josephrubin/Elijah/image/band.jpg

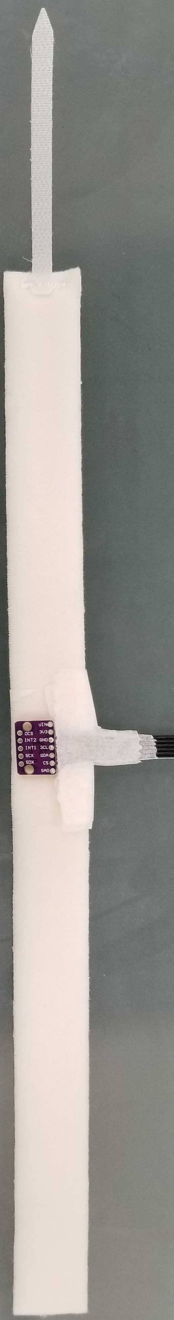
image/band.jpg
