josephrubin/Elijah/image/lit_b.jpg

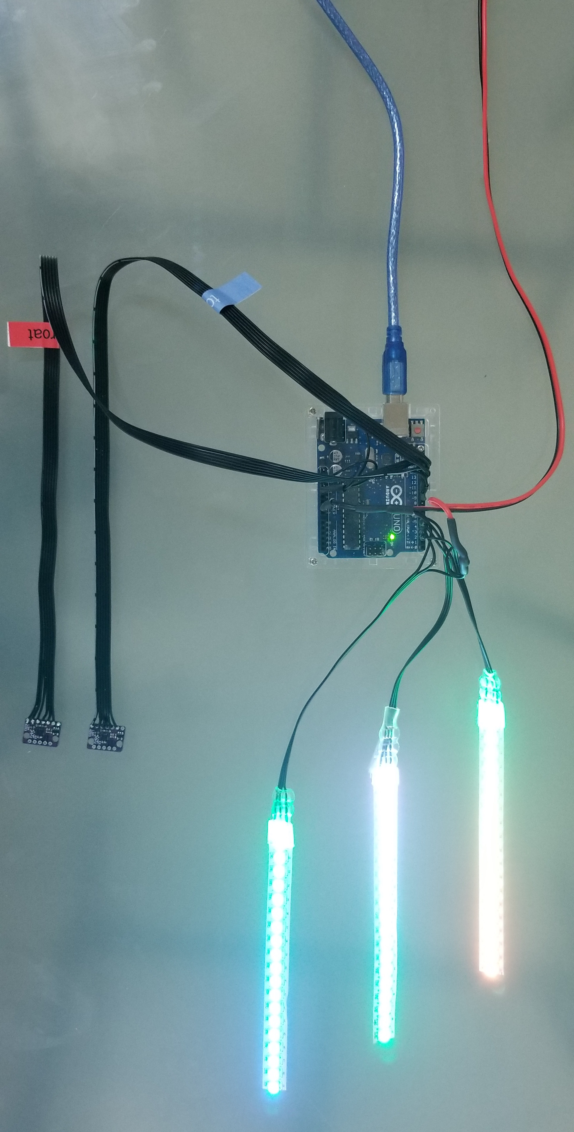
image/lit_b.jpg
