josephrubin/Elijah/README.md

# Elijah
The purpose of Elijah is to provide doctors with an accurate and unobtrusive external swallowing monitor for babies and young children.
Elijah is more convenient than floroscopy, more comfortable than endoscopy, and more precise than using a stethescope.

### Contributing
Read spec/xtra/specification.pdf, especially the hardware section, to build your own setup of Elijah and begin contributing to its codebase.
