josephrubin/Elijah/image/angle.jpg

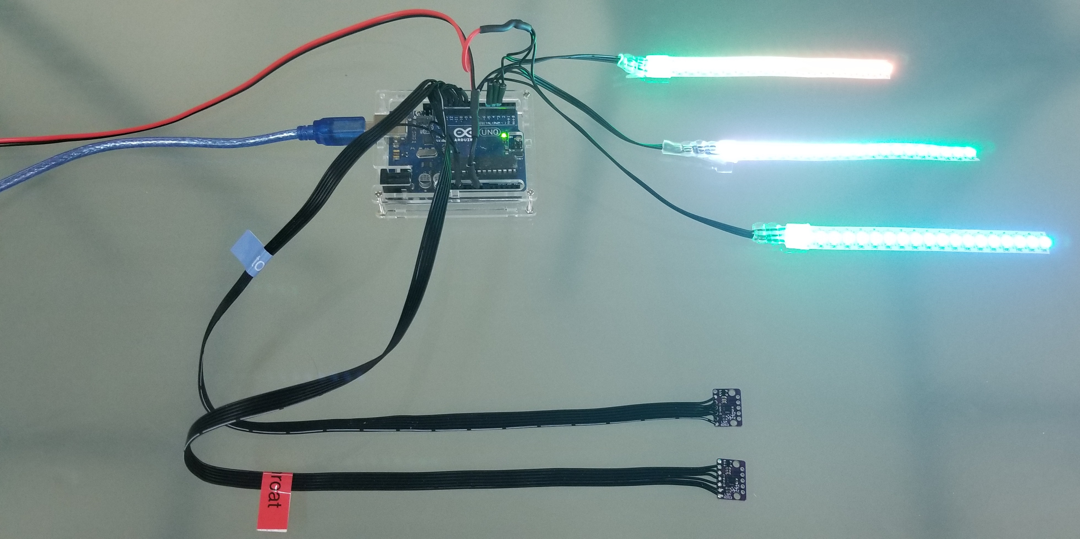
image/angle.jpg
