josephrubin/Elijah/image/close.jpg

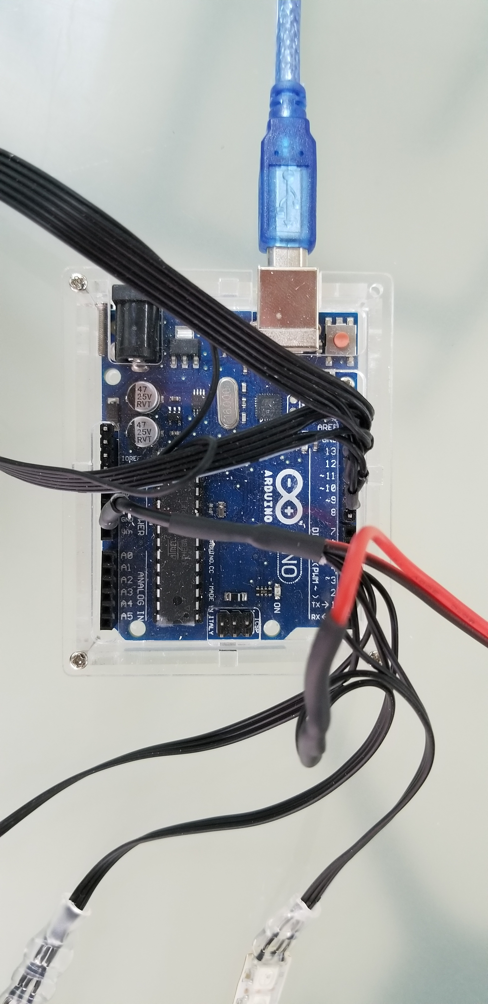
image/close.jpg
