josephrubin/Elijah/image/gui_empty.png

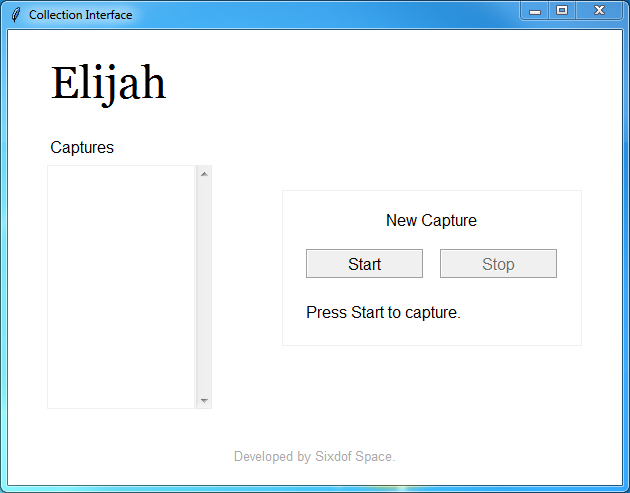
image/gui_empty.png
