josephrubin/Elijah/image/gui_full.png

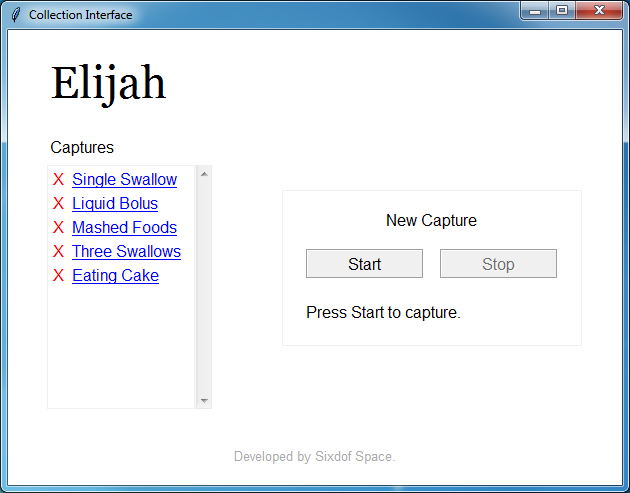
image/gui_full.png
