josephrubin/Elijah/image/limit_switch.jpg

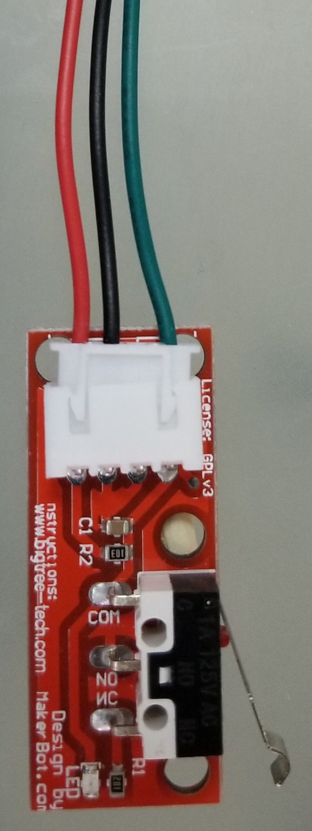
image/limit_switch.jpg
