josephrubin/Elijah/image/lit_a.jpg

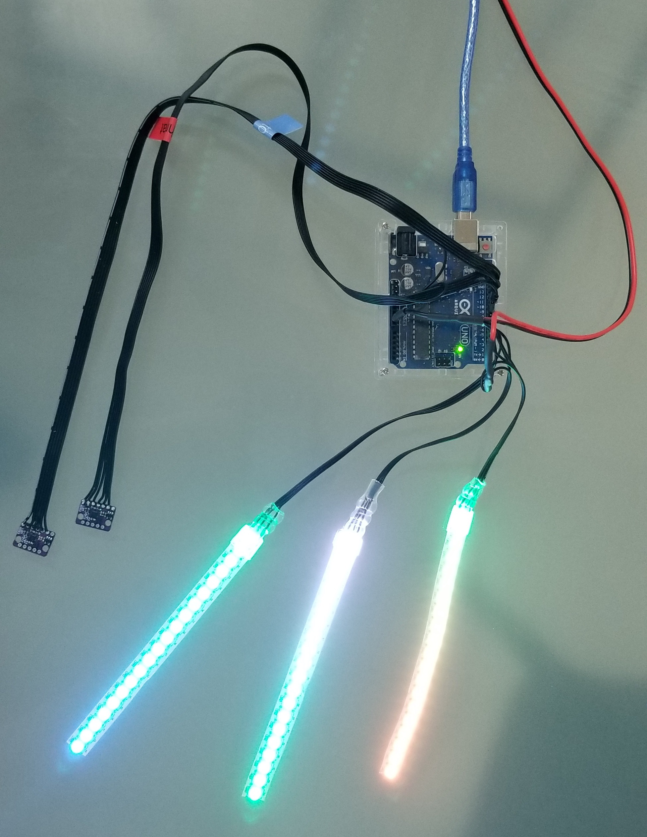
image/lit_a.jpg
