josephrubin/Elijah/image/mems.jpg

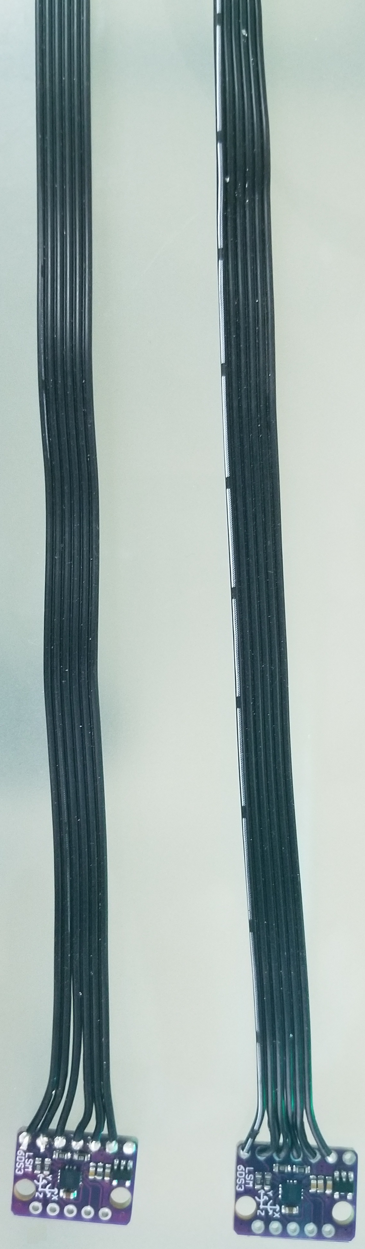
image/mems.jpg
