josephrubin/Elijah/image/patient_x.png

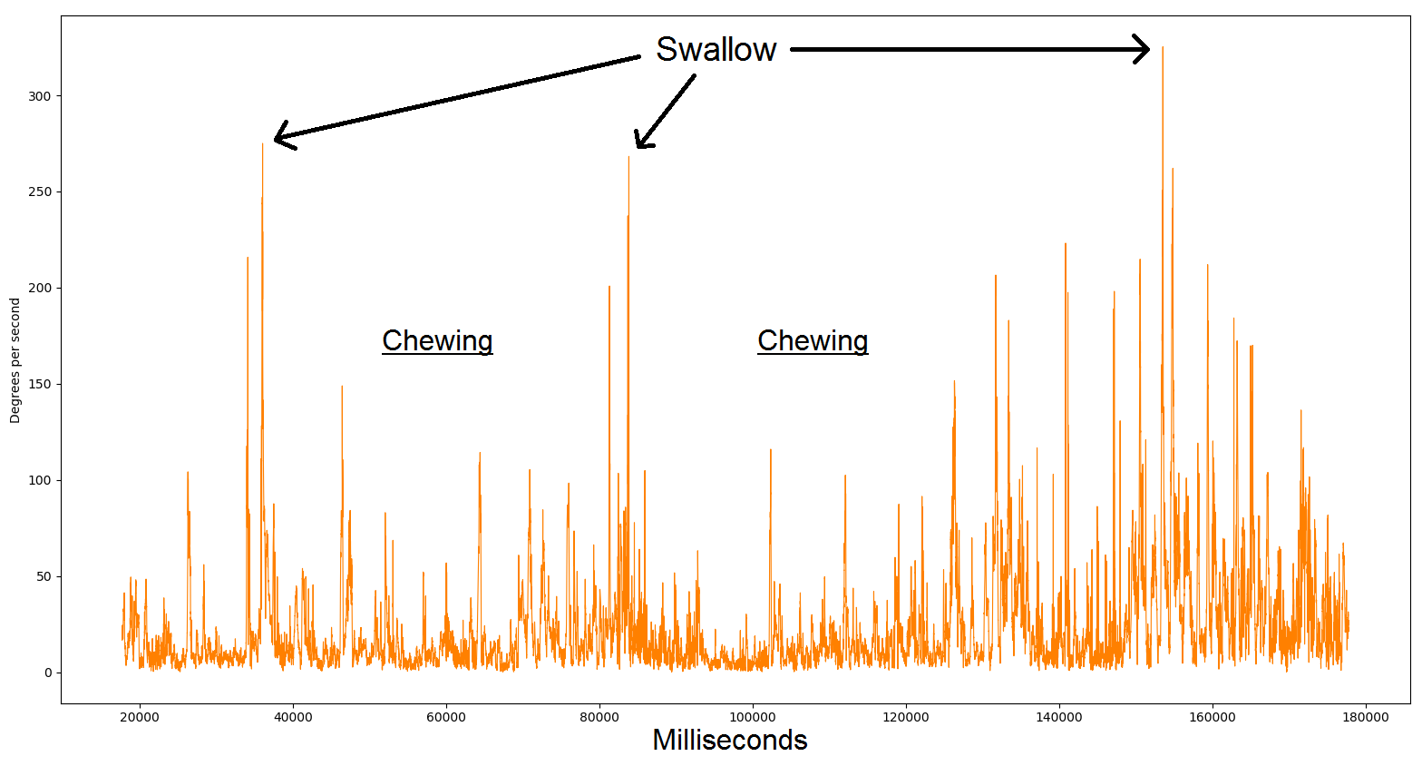
image/patient_x.png
