josephrubin/Elijah/image/plot.png

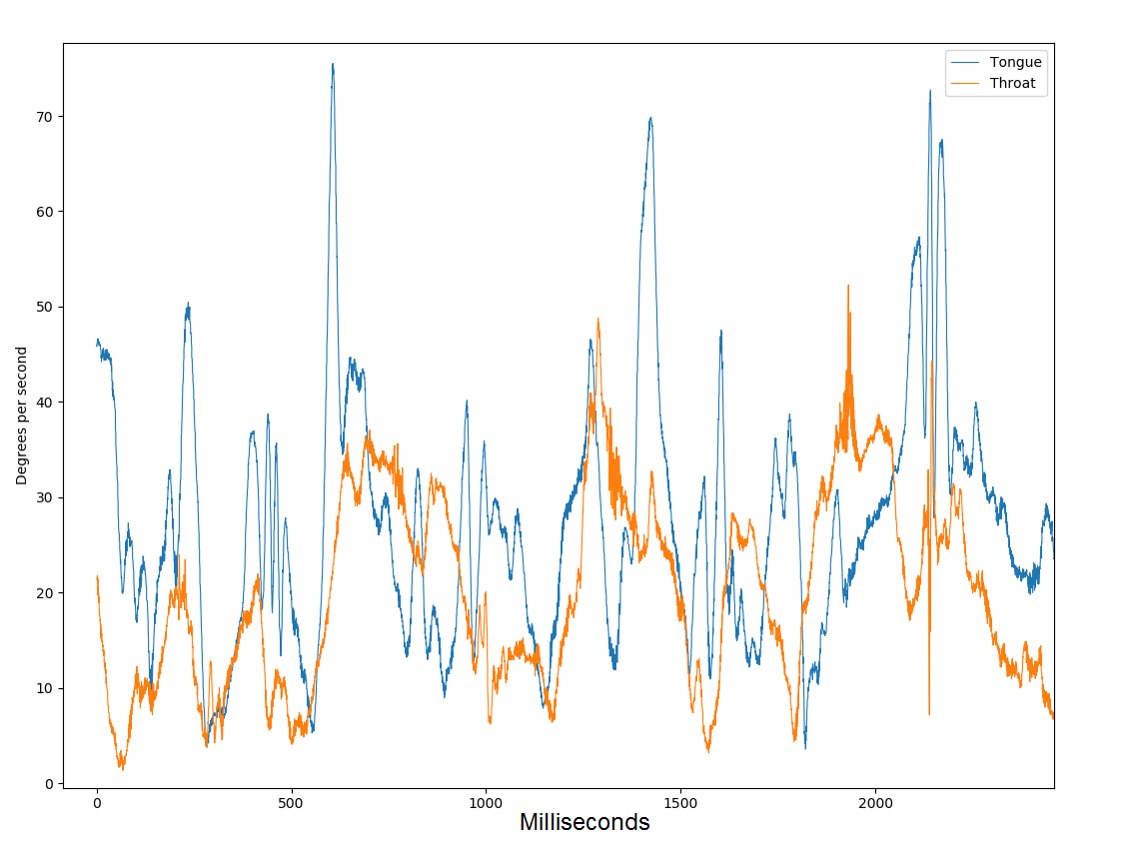
image/plot.png
