josephrubin/Elijah/image/strips.jpg

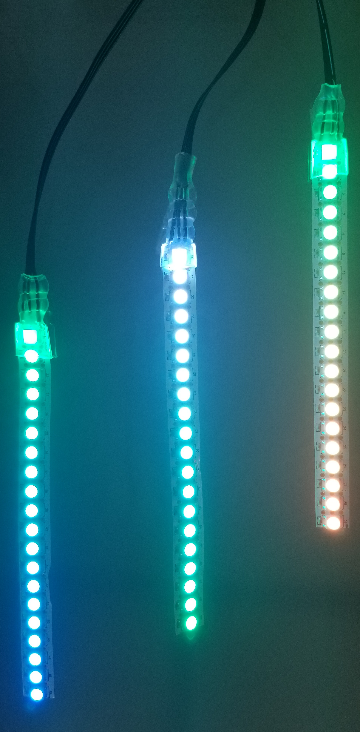
image/strips.jpg
