josephrubin/Elijah/image/unlit_a.jpg

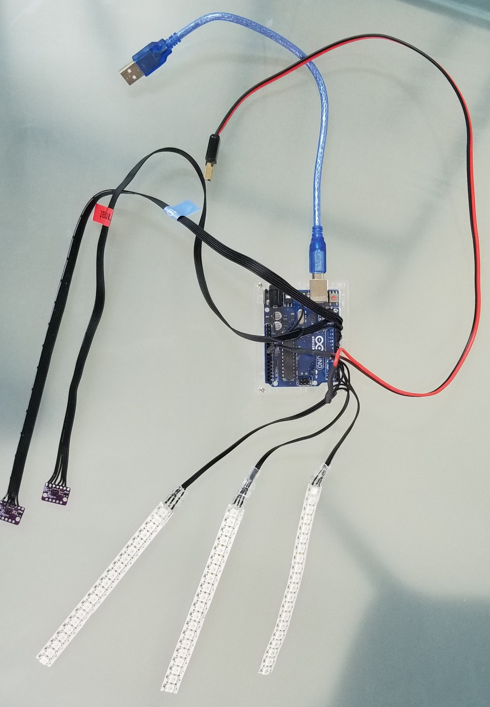
image/unlit_a.jpg
