josephrubin/Elijah/image/unlit_b.jpg

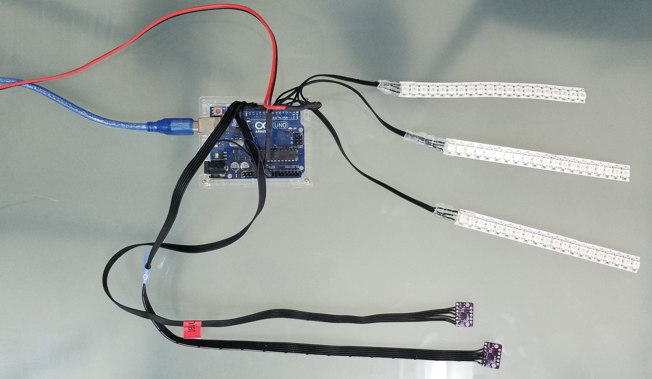
image/unlit_b.jpg
