josephrubin/Elijah/image/led_strip_wiring.png

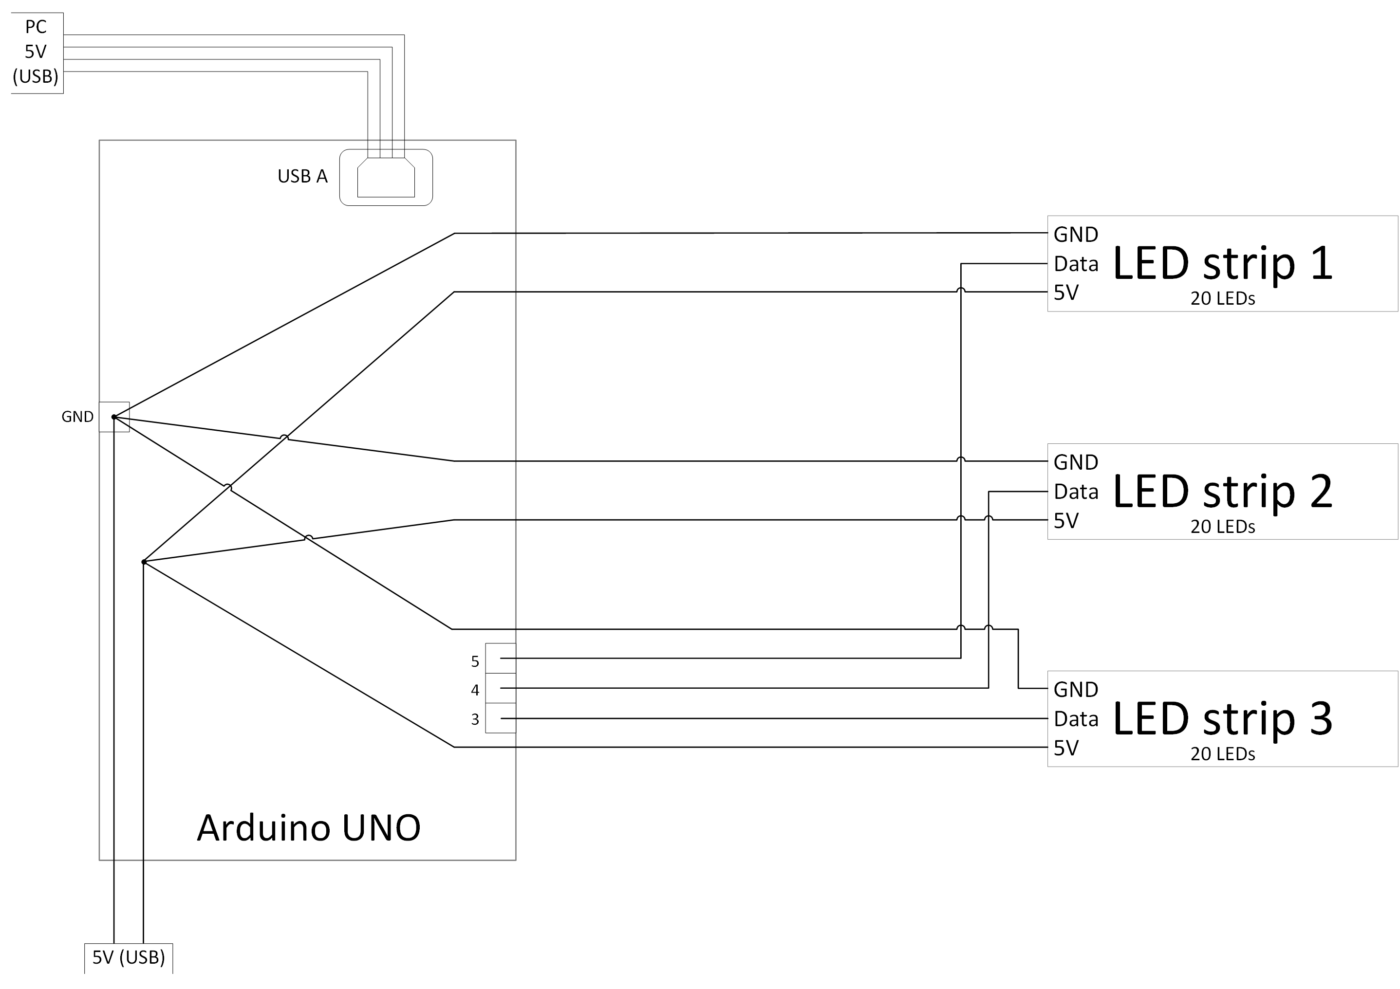
image/led_strip_wiring.png
