josephrubin/Elijah/image/mems_spi_wiring.png

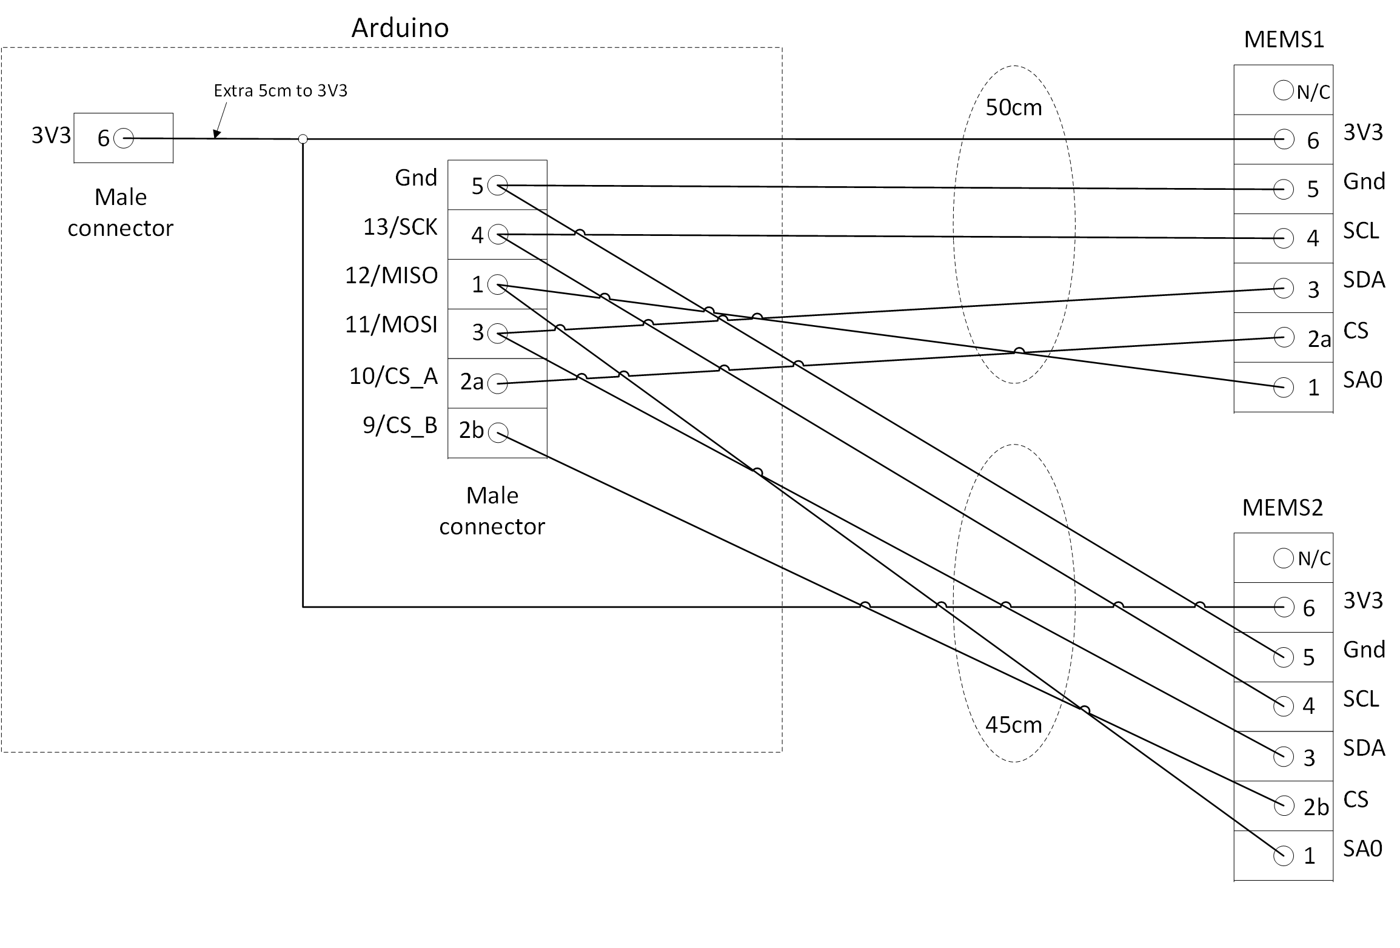
image/mems_spi_wiring.png
